PerePala/VentiladorUPCManresa/electronics/main board/UPC-EURS.ods

Source: | /home/joan/Kicad Porjects/UPC-EURS V3/UPC-EURS.sch
Date: | dijous, 14 de maig de 2020, 18:09:15 CEST
Tool: | Eeschema 5.1.6-c6e7f7d~86~ubuntu18.04.1
Generator: | /usr/share/kicad/plugins/bom_csv_grouped_by_value_with_fp.py
Component Count: | 42
Ref | Qnty | Value | Cmp name | Footprint | Description | Vendor | Codi | €/ut. | €
A1, | 1 | Arduino_UNO_R3 | Arduino_UNO_R3 | Module:Arduino_UNO_R3 | Arduino UNO Microcontroller Module, release 3 |  |  |  | 0,00 €
A2, | 1 | DRV8825 | Pololu_Breakout_DRV8825 | Module:Pololu_Breakout-16_15.2x20.3mm | Pololu Breakout Board, Stepper Driver DRV8825 |  |  |  | 0,00 €
BZ1, | 1 | Buzzer | Buzzer | Buzzer_Beeper:Buzzer_12x9.5RM7.6 | Buzzer, polarized |  |  |  | 0,00 €
C1, C5, | 2 | 100uF | CP | Capacitor_THT:CP_Radial_D8.0mm_P3.50mm | Polarized capacitor |  |  |  | 0,00 €
C2, | 1 | 2200uF | CP | Capacitor_THT:CP_Radial_D16.0mm_P7.50mm | Polarized capacitor |  |  |  | 0,00 €
C3, C4, | 2 | 100nF | C | Capacitor_SMD:C_0805_2012Metric_Pad1.15x1.40mm_HandSolder | Unpolarized capacitor |  |  |  | 0,00 €
C6, | 1 | 1nF | C | Capacitor_SMD:C_0805_2012Metric_Pad1.15x1.40mm_HandSolder | Unpolarized capacitor |  |  |  | 0,00 €
D1, D2, | 2 | 1N4001 | 1N4001 | Diode_THT:D_DO-41_SOD81_P10.16mm_Horizontal | 50V 1A General Purpose Rectifier Diode, DO-41 |  |  |  | 0,00 €
D3, | 1 | 1N5820 | 1N5820 | Diode_THT:D_DO-201AD_P15.24mm_Horizontal | 20V 3A Schottky Barrier Rectifier Diode, DO-201AD |  |  |  | 0,00 €
D4, | 1 | LED | LED | LED_THT:LED_D5.0mm | Light emitting diode |  |  |  | 0,00 €
DS1, | 1 | I2C_Display_PCF8574 | I2C_Display_PCF8574 | MyLib:Display 20x4 I2C |  |  |  |  | 0,00 €
F1, | 1 | Fuse | Fuse | MyLib:Radial_Lead_Micro_Fuse | Fuse |  |  |  | 0,00 €
J1, | 1 | EXT DC | Conn_01x02 | TerminalBlock:TerminalBlock_bornier-2_P5.08mm | Generic connector, single row, 01x02, script generated (kicad-library-utils/schlib/autogen/connector/) |  |  |  | 0,00 €
J2, | 1 | USB_B | USB_B | Connector_USB:USB_B_OST_USB-B1HSxx_Horizontal | USB Type B connector |  |  |  | 0,00 €
J3, | 1 | Conn_01x05 | Conn_01x05 | Connector_Molex:Molex_SL_171971-0005_1x05_P2.54mm_Vertical | Generic connector, single row, 01x05, script generated (kicad-library-utils/schlib/autogen/connector/) |  |  |  | 0,00 €
J4, | 1 | Motor B | Conn_01x04_Male | TerminalBlock:TerminalBlock_bornier-4_P5.08mm | Generic connector, single row, 01x04, script generated (kicad-library-utils/schlib/autogen/connector/) |  |  |  | 0,00 €
J5, | 1 | Conn_01x04 | Conn_01x04 | Connector_Molex:Molex_SL_171971-0004_1x04_P2.54mm_Vertical | Generic connector, single row, 01x04, script generated (kicad-library-utils/schlib/autogen/connector/) |  |  |  | 0,00 €
L1, | 1 | 150uH | L | Inductor_THT:L_Radial_D8.7mm_P5.00mm_Fastron_07HCP | Inductor |  |  |  | 0,00 €
R1, R4, R6, R7, R8, | 5 | 1k | R | Resistor_SMD:R_0805_2012Metric_Pad1.15x1.40mm_HandSolder | Resistor |  |  |  | 0,00 €
R2, | 1 | 5k6 | R | Resistor_SMD:R_0805_2012Metric_Pad1.15x1.40mm_HandSolder | Resistor |  |  |  | 0,00 €
R3, | 1 | 2k7 | R | Resistor_SMD:R_0805_2012Metric_Pad1.15x1.40mm_HandSolder | Resistor |  |  |  | 0,00 €
R5, | 1 | 560 Ohm | R | Resistor_SMD:R_0805_2012Metric_Pad1.15x1.40mm_HandSolder | Resistor |  |  |  | 0,00 €
SW1, | 5 | SW_Push | SW_Push | Button_Switch_THT:SW_PUSH_6mm_H13mm | Push button switch, generic, two pins |  |  |  | 0,00 €
SW4, | 1 | Rotary_Encoder_Switch | Rotary_Encoder_Switch | Rotary_Encoder:RotaryEncoder_Alps_EC12E-Switch_Vertical_H20mm_CircularMountingHoles | Rotary encoder, dual channel, incremental quadrate outputs, with switch |  |  |  | 0,00 €
U1, | 1 | LM2575-12BU | LM2575-12BU | Package_TO_SOT_SMD:TO-263-5_TabPin3 | Fixed 12V 52kHz Simple 1A Buck Regulator, TO-263 |  |  |  | 0,00 €
U2, | 1 | LM1117-5.0 | LM1117-5.0 | Package_TO_SOT_SMD:SOT-223 | 800mA Low-Dropout Linear Regulator, 5.0V fixed output, TO-220/TO-252/TO-263/SOT-223 |  |  |  | 0,00 €
U3, | 1 | ESP-WROOM-32S_MODULE | ESP-WROOM-32S_MODULE | MyLib:ESP32_MODULE | Dev Module based on ESP32 |  |  |  | 0,00 €
 |  |  |  |  |  |  |  | NET | 0,00 €
 |  |  |  |  |  |  |  | IVA | 0,00 €
 |  |  |  |  |  |  |  | TOTAL | 0,00 €
