PerePala/VentiladorUPCManresa/electronics/pressure sensor board/pressure sensor board.kicad_pcb

## KiCad design electronics/pressure sensor board/pressure sensor board.kicad_pcb (2020-07-06)

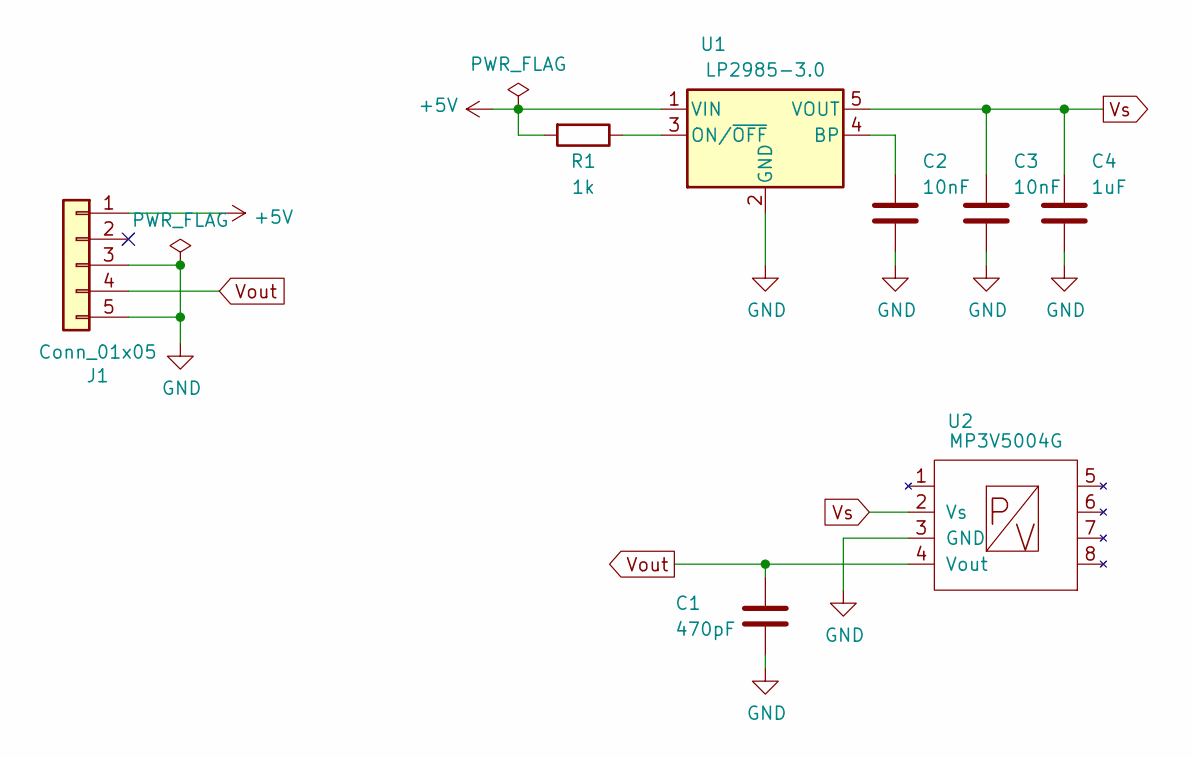
[picture p1: schematic pressure sensor board.sch]

Parts:
C1: 470pF; C_0805_2012Metric_Pad1.15x1.40mm_HandSolder
C2, C3: 10nF; C_0805_2012Metric_Pad1.15x1.40mm_HandSolder
C4: 1uF; C_0805_2012Metric_Pad1.15x1.40mm_HandSolder
J1: Conn_01x05; Molex_SL_171971-0005_1x05_P2.54mm_Vertical
R1: 1k; R_0805_2012Metric_Pad1.15x1.40mm_HandSolder
U1: LP2985-3.0; SOT-23-5
U2: MP3V5004G; MP3V5004

Connections:
+5V: J1.1, R1.2, U1.1 (VIN)
GND: C1.2, C2.2, C3.2, C4.2, J1.3, J1.5, U1.2 (GND), U2.3 (GND)
unnamed: C2.1, U1.4 (BP)
unnamed: R1.1, U1.3 (ON/~OFF~)
Vout: C1.1, J1.4, U2.4 (Vout)
Vs: C3.1, C4.1, U1.5 (VOUT), U2.2 (Vs)

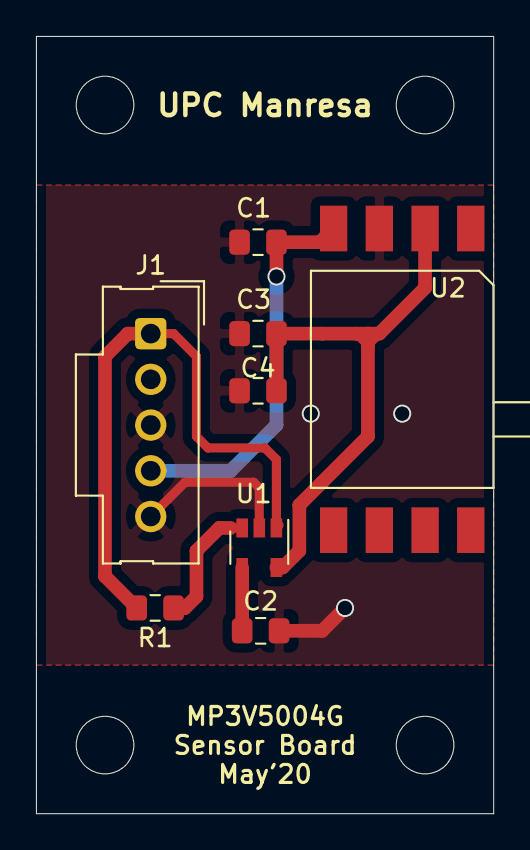
[picture p2: board pressure sensor board.kicad_pcb from above]

Board: 2 copper layers, 25.4 x 43.2 mm, 8 parts (0 on the bottom side), 6 nets.
