PerePala/VentiladorUPCManresa/electronics/main board/UPC-EURS.kicad_pcb

## KiCad design electronics/main board/UPC-EURS.kicad_pcb (2020-07-06)

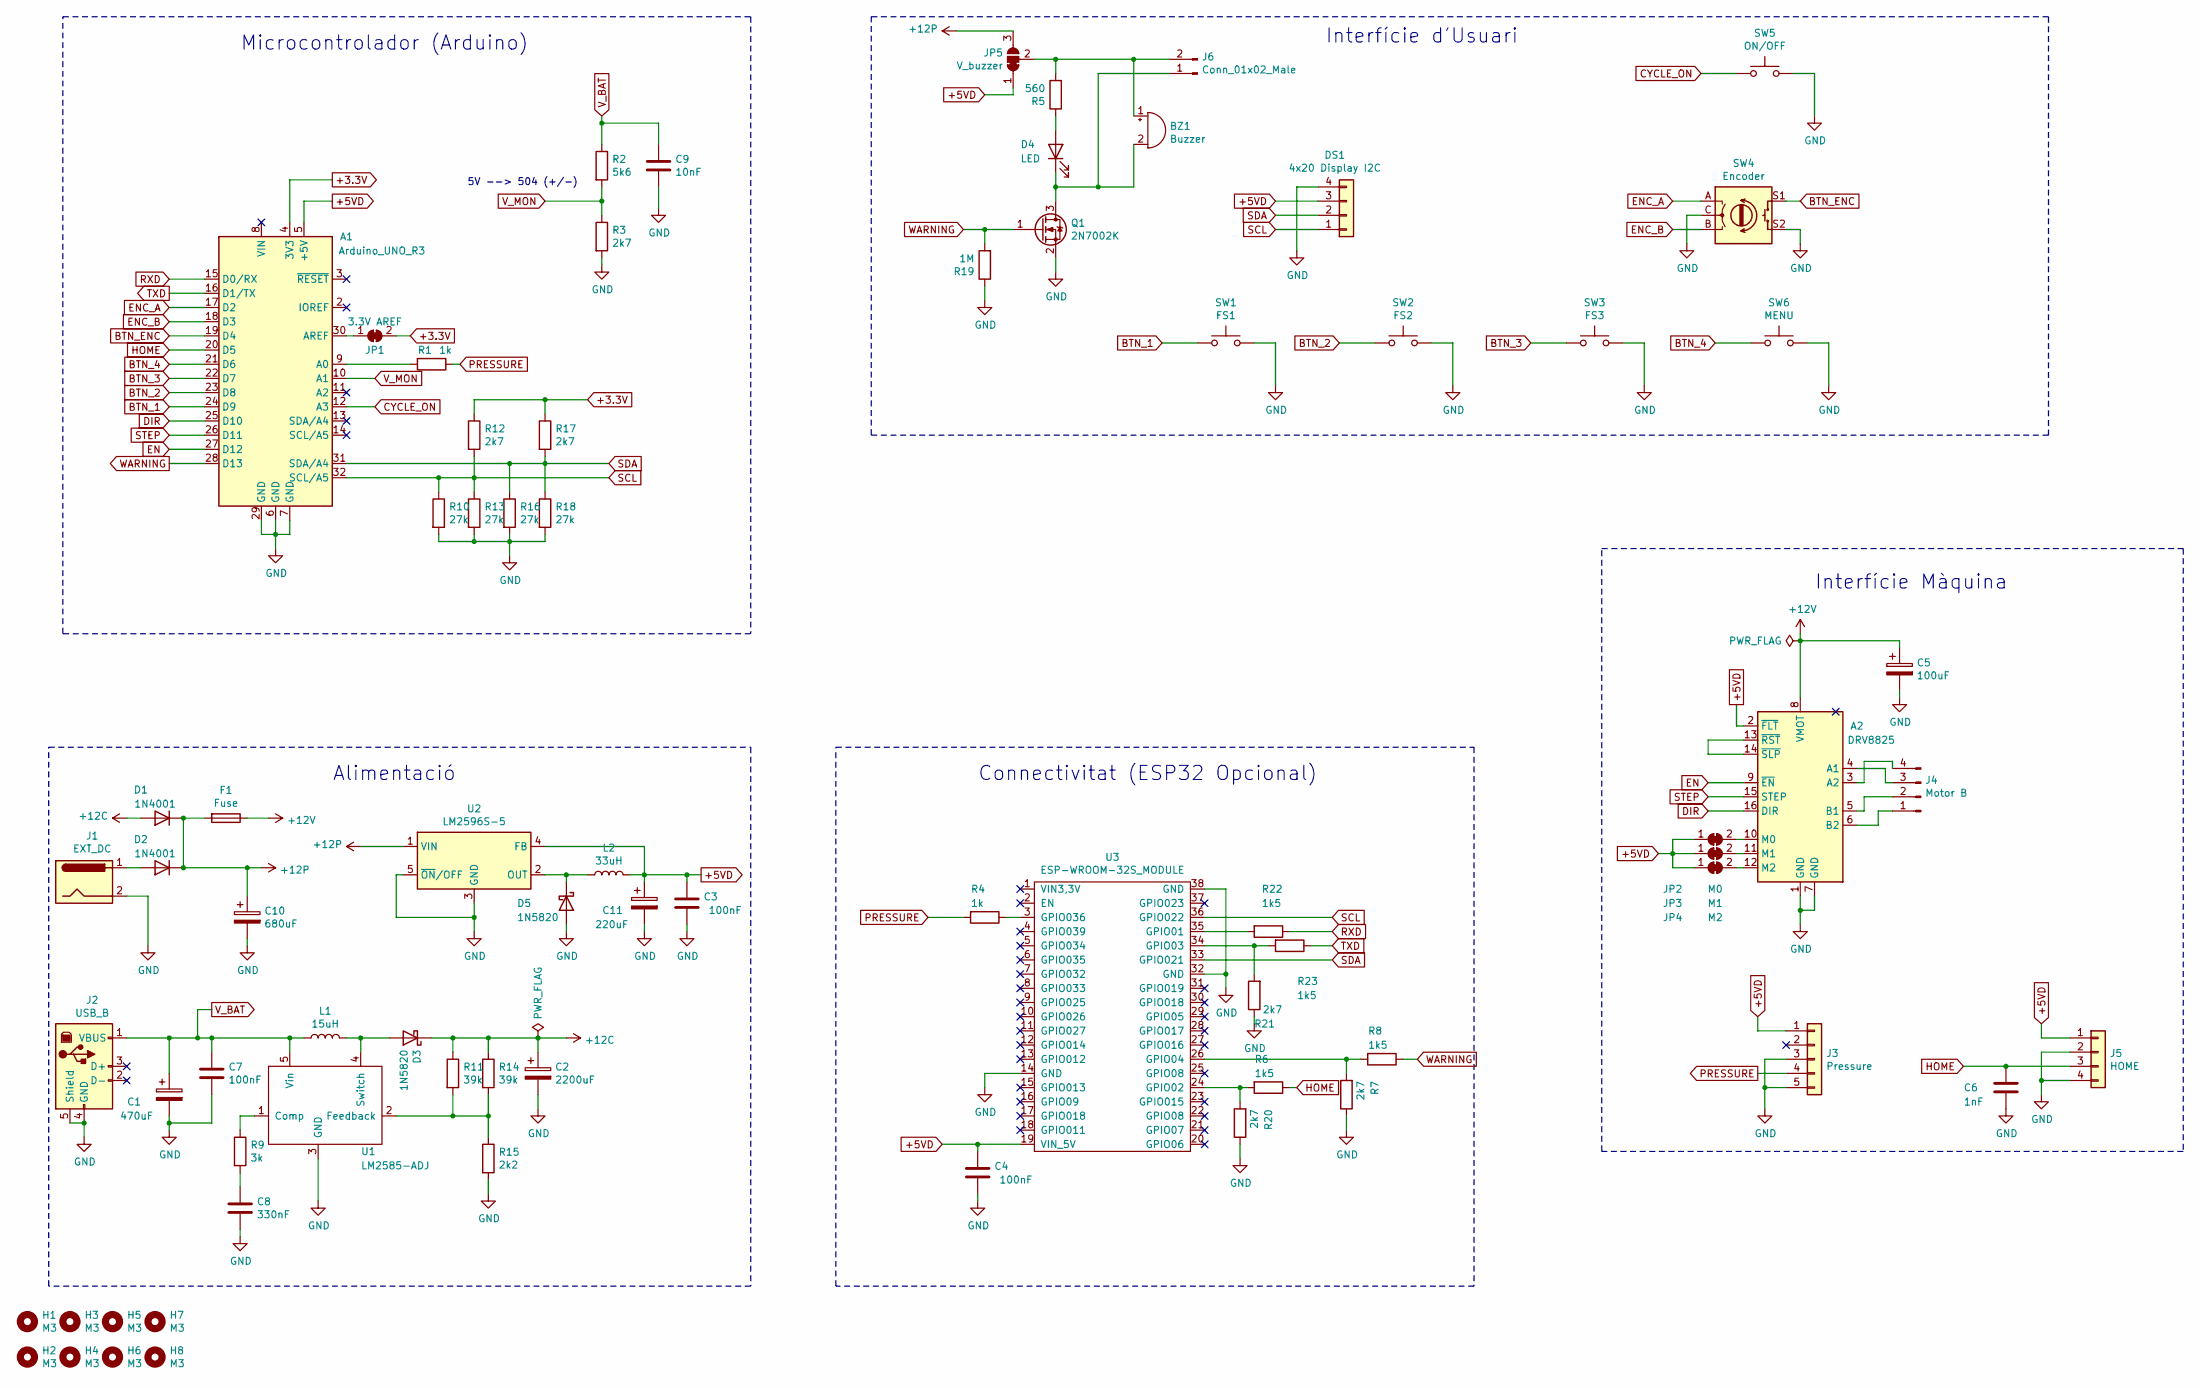
[picture p3: schematic UPC-EURS.sch, Respirador EPSEM]

Parts:
A1: Arduino_UNO_R3
A2: DRV8825; Pololu_Breakout-16_15.2x20.3mm
BZ1: Buzzer; Buzzer_12x9.5RM7.6
C1: 470uF; CP_Radial_D8.0mm_P3.50mm
C2: 2200uF; CP_Radial_D16.0mm_P7.50mm
C3, C4, C7: 100nF; C_0805_2012Metric_Pad1.15x1.40mm_HandSolder
C5: 100uF; CP_Radial_D8.0mm_P3.50mm
C6: 1nF; C_0805_2012Metric_Pad1.15x1.40mm_HandSolder
C8: 330nF; C_0805_2012Metric_Pad1.15x1.40mm_HandSolder
C9: 10nF; C_0805_2012Metric_Pad1.15x1.40mm_HandSolder
C10: 680uF; CP_Radial_D12.5mm_P5.00mm
C11: 220uF; CP_Radial_D8.0mm_P3.50mm
D1, D2: 1N4001; D_DO-41_SOD81_P10.16mm_Horizontal
D3, D5: 1N5820; D_DO-201AD_P15.24mm_Horizontal
D4: LED; LED_D5.0mm
DS1: 4x20 Display I2C; PinSocket_1x04_P2.54mm_Horizontal
F1: Fuse; Radial_Lead_Micro_Fuse
H1, H2, H3, H4, H5, H6, H7, H8: M3; MountingHole_3.2mm_M3
J1: EXT_DC; BarrelJack_Horizontal
J2: USB_B; USB_B_OST_USB-B1HSxx_Horizontal
J3: Pressure; Molex_SL_171971-0005_1x05_P2.54mm_Vertical
J4: Motor B; TerminalBlock_bornier-4_P5.08mm
J5: HOME; Molex_SL_171971-0004_1x04_P2.54mm_Vertical
J6: Conn_01x02_Male; PinHeader_1x02_P2.54mm_Vertical
JP1: 3.3V AREF; SolderJumper-2_P1.3mm_Bridged_Pad1.0x1.5mm
JP2: M0; SolderJumper-2_P1.3mm_Bridged_Pad1.0x1.5mm
JP3: M1; SolderJumper-2_P1.3mm_Bridged_Pad1.0x1.5mm
JP4: M2; SolderJumper-2_P1.3mm_Bridged_Pad1.0x1.5mm
JP5: V_buzzer; SolderJumper-3_P1.3mm_Bridged12_RoundedPad1.0x1.5mm
L1: 15uH; L_Radial_D8.7mm_P5.00mm_Fastron_07HCP
L2: 33uH; L_Radial_D8.7mm_P5.00mm_Fastron_07HCP
Q1: 2N7002K; SOT-23
R1, R4: 1k; R_0805_2012Metric_Pad1.15x1.40mm_HandSolder
R2: 5k6; R_0805_2012Metric_Pad1.15x1.40mm_HandSolder
R3, R7, R12, R17, R20, R21: 2k7; R_0805_2012Metric_Pad1.15x1.40mm_HandSolder
R5: 560; R_0805_2012Metric_Pad1.15x1.40mm_HandSolder
R6, R8, R22, R23: 1k5; R_0805_2012Metric_Pad1.15x1.40mm_HandSolder
R9: 3k; R_0805_2012Metric_Pad1.15x1.40mm_HandSolder
R10, R13, R16, R18: 27k; R_0805_2012Metric_Pad1.15x1.40mm_HandSolder
R11, R14: 39k; R_0805_2012Metric_Pad1.15x1.40mm_HandSolder
R15: 2k2; R_0805_2012Metric_Pad1.15x1.40mm_HandSolder
R19: 1M; R_0805_2012Metric_Pad1.15x1.40mm_HandSolder
SW1: FS1; SW_PUSH_6mm_H13mm
SW2: FS2; SW_PUSH_6mm_H13mm
SW3: FS3; SW_PUSH_6mm_H13mm
SW4: Encoder; RotaryEncoder_Alps_EC12E-Switch_Vertical_H20mm_CircularMoun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
SW5: ON/OFF; SW_PUSH_6mm_H13mm
SW6: MENU; SW_PUSH_6mm_H13mm
U1: LM2585-ADJ; TO-263-5_TabPin6
U2: LM2596S-5; TO-263-5_TabPin3
U3: ESP-WROOM-32S_MODULE; ESP32_MODULE

Connections:
+3.3V: A1.4 (3V3), JP1.2 (B), R12.1, R17.1
+5VD: A1.5 (+5V), A2.2 (~FLT), C3.1, C4.1, C11.1, DS1.3, J3.1, J5.1, JP2.1 (A), JP3.1 (A), JP4.1 (A), JP5.1 (A), L2.2, U2.4 (FB), U3.19 (VIN_5V)
+12C: C2.1, D1.2 (A), D3.1 (K), R11.1, R14.1
+12P: C10.1, D1.1 (K), D2.1 (K), F1.2, JP5.3 (B), U2.1 (VIN)
+12V: A2.8 (VMOT), C5.1, F1.1
BTN_1: A1.24 (D9), SW1.1
BTN_2: A1.23 (D8), SW2.1
BTN_3: A1.22 (D7), SW3.1
BTN_4: A1.21 (D6), SW6.1
BTN_ENC: A1.19 (D4), SW4.S1
CYCLE_ON: A1.12 (A3), SW5.1
DIR: A1.25 (D10), A2.16 (DIR)
EN: A1.27 (D12), A2.9 (~EN)
ENC_A: A1.17 (D2), SW4.A
ENC_B: A1.18 (D3), SW4.B
GND: A1.6 (GND), A1.7 (GND), A1.29 (GND), A2.1 (GND), A2.7 (GND), C1.2, C2.2, C3.2, C4.2, C5.2, C6.2, C7.2, C8.2, C9.2, C10.2, C11.2, D5.2 (A), DS1.4, J1.2, J1.3, J2.4 (GND), J2.5 (Shield), J3.3, J3.5, J5.2, J5.4, Q1.2 (S), R3.2, R7.1, R10.2, R13.2, R15.2, R16.2, R18.2, R19.1, R20.1, R21.1, SW1.2, SW2.2, SW3.2, SW4.C, SW4.MP, SW4.S2, SW5.2, SW6.2, U1.3 (GND), U2.3 (GND), U2.5 (~ON~/OFF), U3.14 (GND), U3.32 (GND), U3.38 (GND)
HOME: A1.20 (D5), C6.1, J5.3, R6.1
unnamed: A1.9 (A0), R1.2
unnamed: A1.30 (AREF), JP1.1 (A)
unnamed: A2.3 (A2), J4.4
unnamed: A2.4 (A1), J4.3
unnamed: A2.5 (B1), J4.2
unnamed: A2.6 (B2), J4.1
unnamed: A2.10 (M0), JP2.2 (B)
unnamed: A2.11 (M1), JP3.2 (B)
unnamed: A2.12 (M2), JP4.2 (B)
unnamed: A2.13 (~RST), A2.14 (~SLP)
unnamed: BZ1.1 (-), J6.2, JP5.2 (C), R5.2
unnamed: BZ1.2 (+), D4.1 (K), J6.1, Q1.3 (D)
unnamed: C8.1, R9.2
unnamed: D2.2 (A), J1.1
unnamed: D3.2 (A), L1.2, U1.4 (Switch)
unnamed: D4.2 (A), R5.1
unnamed: D5.1 (K), L2.1, U2.2 (OUT)
unnamed: R4.1, U3.3 (GPIO036)
unnamed: R7.2, R8.2, U3.26 (GPIO04)
unnamed: R9.1, U1.1 (Comp)
unnamed: R11.2, R14.2, R15.1, U1.2 (Feedback)
unnamed: R6.2, R20.2, U3.24 (GPIO02)
unnamed: R21.2, R23.2, U3.34 (GPIO03)
unnamed: R22.2, U3.35 (GPIO01)
PRESSURE: J3.4, R1.1, R4.2
RXD: A1.15 (D0/RX), R22.1
SCL: A1.32 (SCL/A5), DS1.1, R10.1, R12.2, R13.1, U3.36 (GPIO022)
SDA: A1.31 (SDA/A4), DS1.2, R16.1, R17.2, R18.1, U3.33 (GPIO021)
STEP: A1.26 (D11), A2.15 (STEP)
TXD: A1.16 (D1/TX), R23.1
V_BAT: C1.1, C7.1, C9.1, J2.1 (VBUS), L1.1, R2.1, U1.5 (Vin)
V_MON: A1.10 (A1), R2.2, R3.1
WARNING: A1.28 (D13), Q1.1 (G), R8.1, R19.2

Notes on the sheet:
5V --> 504 (+/-)
Interfície d'Usuari
Microcontrolador (Arduino)
Alimentació
Connectivitat (ESP32 Opcional)
Interfície Màquina

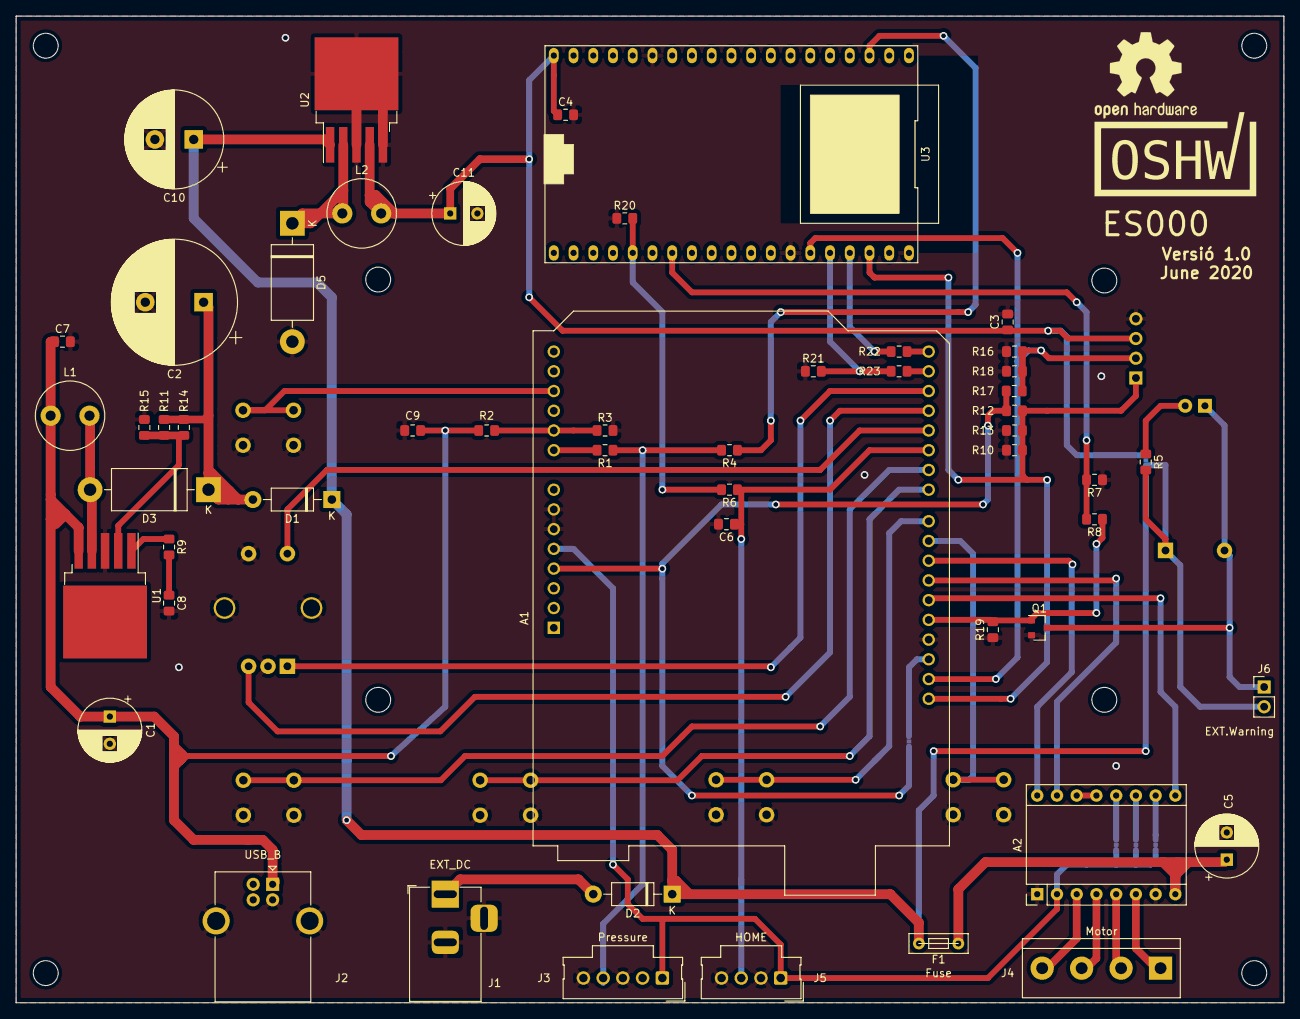
[picture p4: board UPC-EURS.kicad_pcb from above]

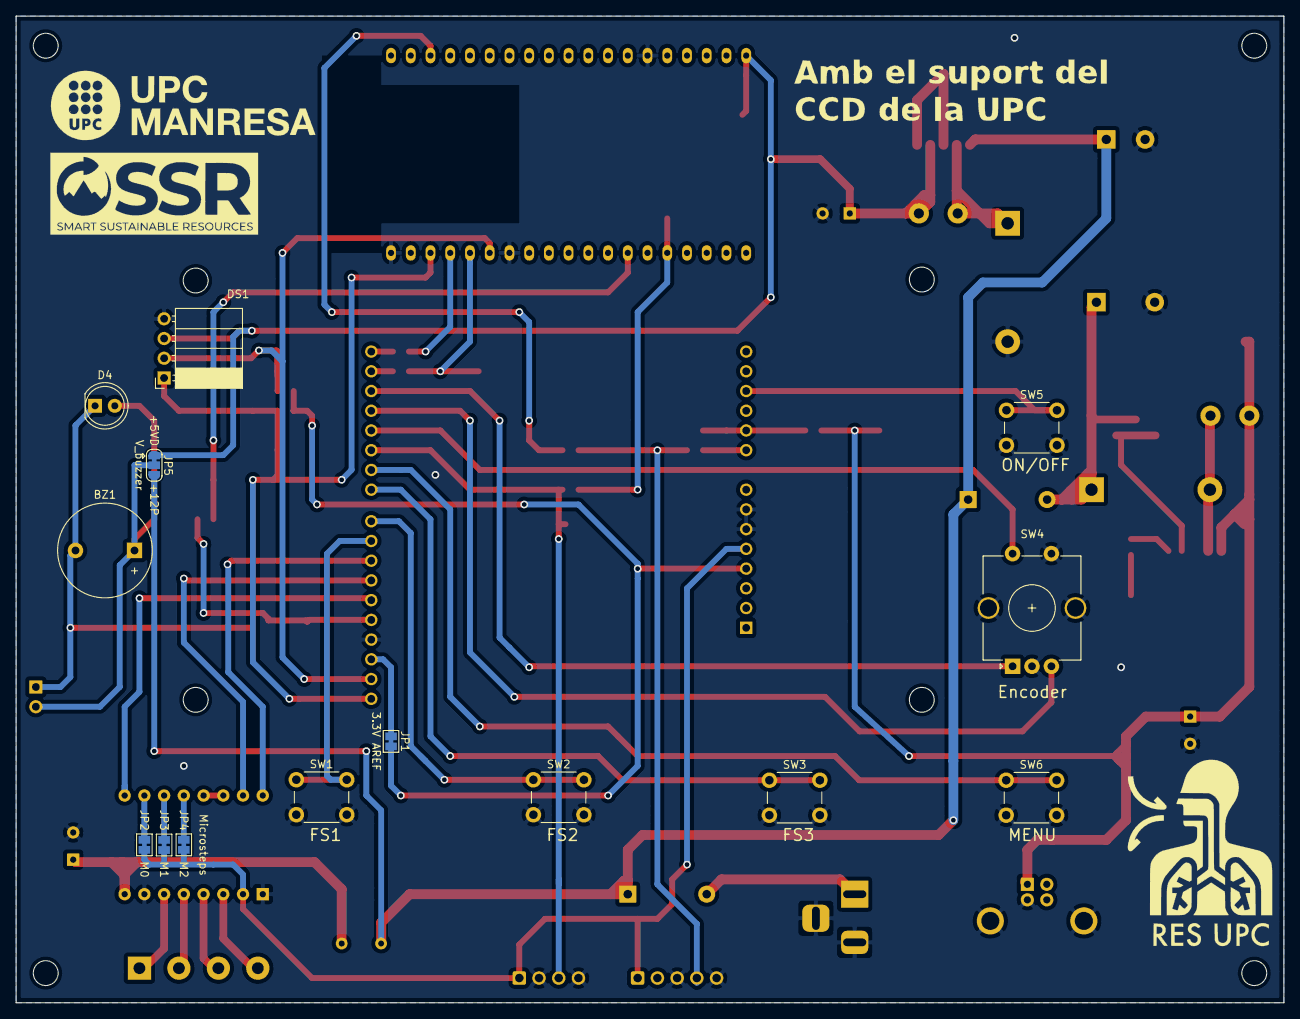
[picture p5: board UPC-EURS.kicad_pcb from below]

Board: 2 copper layers, 163.2 x 127.0 mm, 76 parts (14 on the bottom side), 50 nets.

Other parts of the board:
OSHW_Mono_0.5_Scale: ES000; OSHW_Mono_0.5_Scale
