PerePala/VentiladorUPCManresa/(commit log)

2020-07-06 Afegit nou directori de hardware electronic
    [UPC-EURS-B_Cu.gbr, UPC-EURS-B_Mask.gbr, UPC-EURS-B_Paste.gbr, UPC-EURS-B_SilkS.gbr, UPC-EURS-Edge_Cuts.gbr, UPC-EURS-F_Cu.gbr, UPC-EURS-F_Mask.gbr, UPC-EURS-F_Paste.gbr]
2020-12-08 Implemented the I2C display and the main UI functions.
2020-12-16 Motor pins changed according to the schematics
2020-12-17 Changed ENABLE motor's logic (LOW = Enabled)
2020-12-18 Add switch.c to UI. Add start/stop to vaction
2020-12-18 Modules changed by switch module
2020-12-18 #include "button.h" not needed anymore
